kleintonno/diy-ai-gpu-server/images/r04-complete-front.png

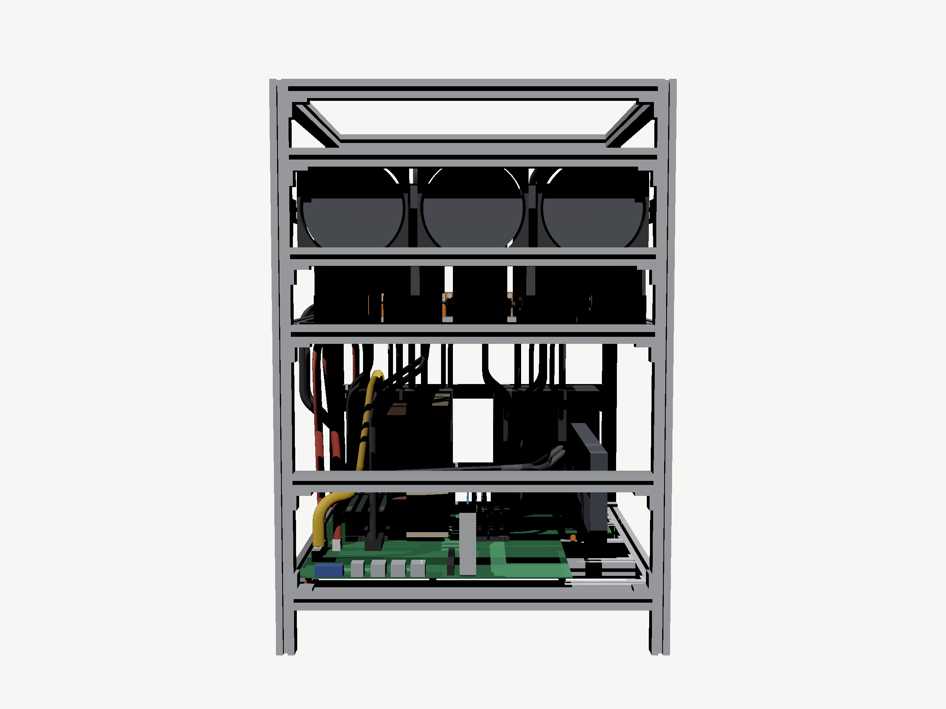
images/r04-complete-front.png
