kleintonno/diy-ai-gpu-server/images/r05-complete-top.png

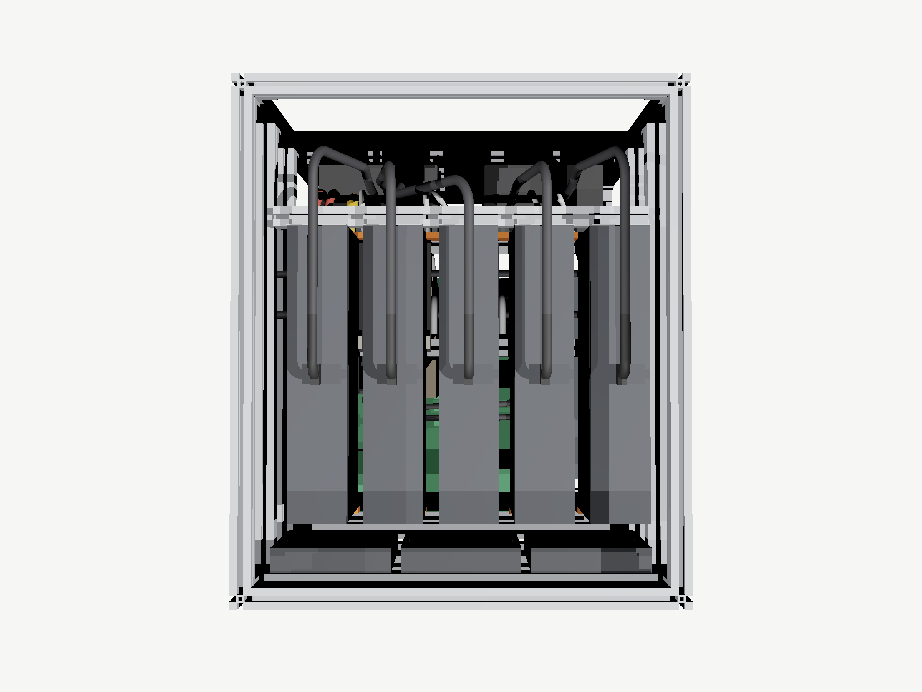
images/r05-complete-top.png
