kleintonno/diy-ai-gpu-server/images/r07-complete-left.png

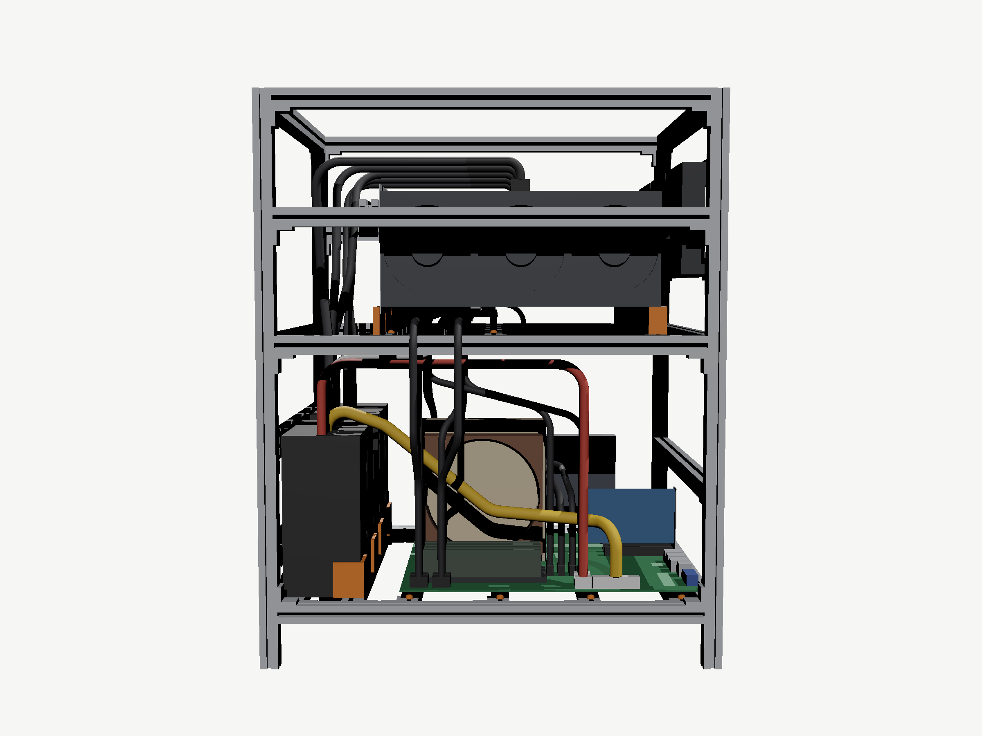
images/r07-complete-left.png
