kleintonno/diy-ai-gpu-server/images/r13-frame-iso-front-right.png

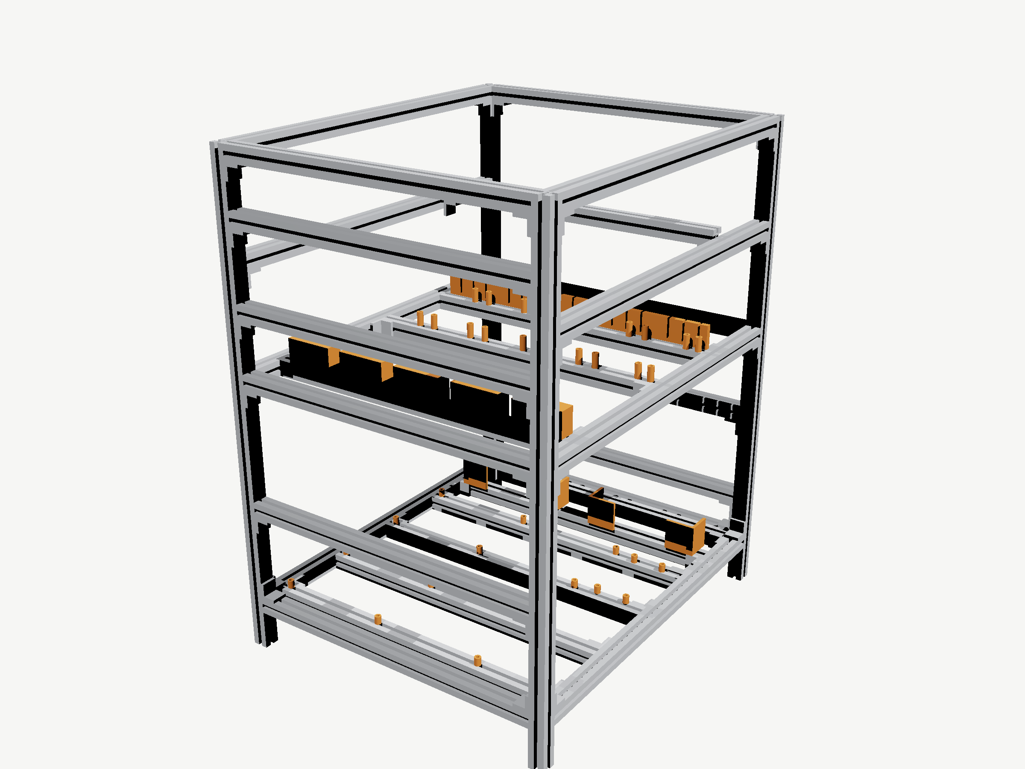
images/r13-frame-iso-front-right.png
