kleintonno/diy-ai-gpu-server/images/r15-frame-top.png

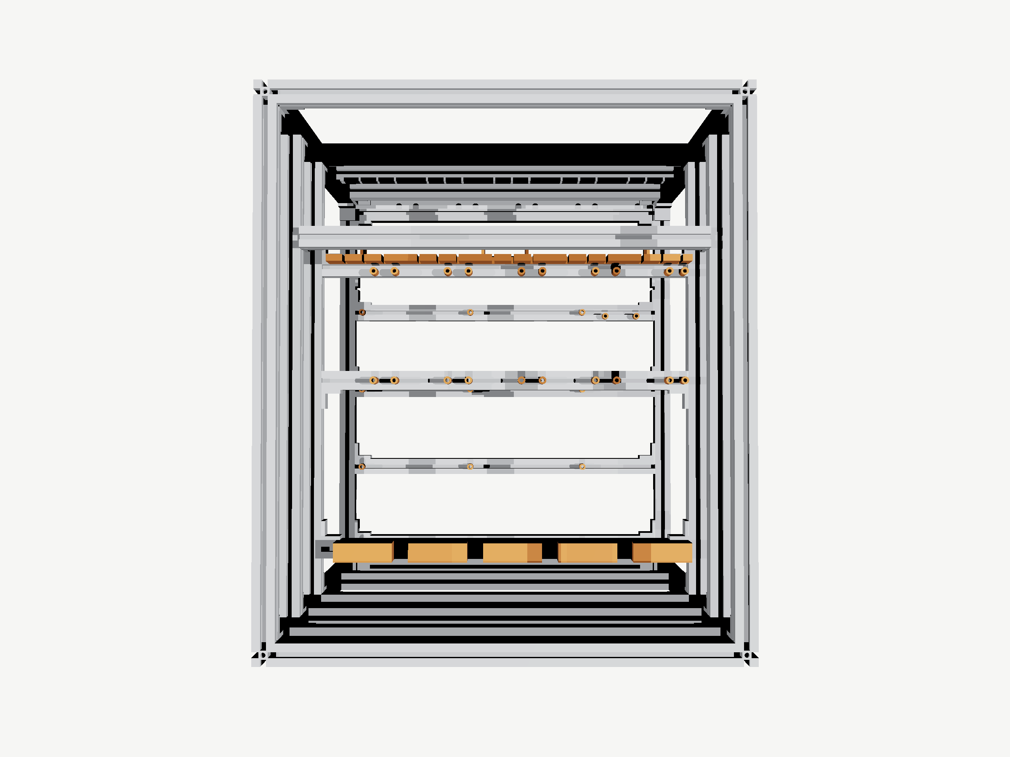
images/r15-frame-top.png
