kleintonno/diy-ai-gpu-server/images/r17-frame-left.png

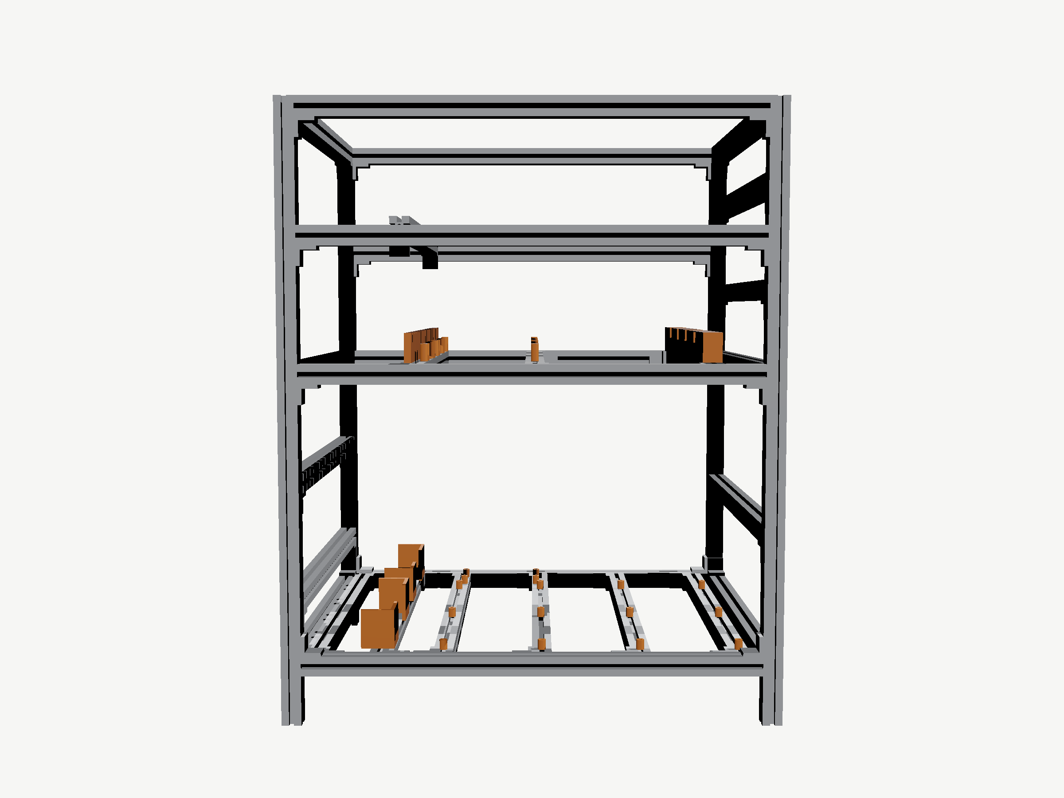
images/r17-frame-left.png
