kleintonno/diy-ai-gpu-server/bom/bom.csv

qty | part_number | description
21 | AL-2020-I5-390 | Aluminium extrusion 20x20 I-type slot 5, 390 mm
8 | AL-2020-I5-460 | Aluminium extrusion 20x20 I-type slot 5, 460 mm
4 | AL-2020-I5-621 | Aluminium extrusion 20x20 I-type slot 5, 621 mm (571 + 50 mm foot)
1 | ASRock-ROMED16QM3 | ASRock Rack ROMED16QM3 (SP3, SSI-EEB), mounted rotated 180°
6 | CPAYNE-X16-BOTTOM | C-Payne PCIe device adapter x8/x16 BOTTOM rev. 2, 2× SlimSAS 8i, 125×30 (1 optional)
16 | PRINT-STANDOFF-8x10 | Standoff Ø8×10, M3 heat-set insert on top (PETG)
24 | PRINT-STANDOFF-8x18 | Riser standoff Ø8×18, M3 heat-set insert on top (PETG)
5 | PRINT-GPU-REST | GPU front rest, 61 mm wide (PETG)
1 | PRINT-GPU6-HOLDER | 6th GPU holder: riser plate + bracket stop (PETG, optional)
1 | PRINT-COMB-1 | Bracket comb segment 1, GPU1–2 (PETG)
1 | PRINT-COMB-2 | Bracket comb segment 2, GPU3 (PETG)
1 | PRINT-COMB-3 | Bracket comb segment 3, GPU4–5 (PETG)
1 | PRINT-PSU-HOLDER-1A | PSU holder, PSU 1 outer (PETG)
1 | PRINT-PSU-HOLDER-1I | PSU holder, PSU 1 inner (PETG)
1 | PRINT-PSU-HOLDER-2A | PSU holder, PSU 2 outer (PETG)
1 | PRINT-PSU-HOLDER-2I | PSU holder, PSU 2 inner (PETG)
1 | PRINT-RACK-EAR-L | 19" rack ear left, retention only (PETG, optional)
1 | PRINT-RACK-EAR-R | 19" rack ear right, retention only (PETG, optional)
3 | FAN-120x25 | Fan 120×120×25
6 | GPU-RTX4090-3S | NVIDIA RTX 4090, 3-slot, 305 mm (1 optional as 6th GPU)
2 | IEC-C13-PLUG | IEC C13 power cord plug (placeholder)
1 | NIC-40G | 40G NIC, low profile, in PCIE8 (placeholder)
1 | Noctua-NH-U14S-TR4-SP3 | Noctua NH-U14S TR4-SP3, rotated 90°, airflow to the right
6 | PSU-CABLE-12V2X6 | 12V-2x6 cable from PSU (1 optional)
5 | PSU-CABLE-PCIE | PCIe 6+2 cable to riser
1 | PSU-CABLE-ATX24 | 24-pin ATX cable
1 | PSU-CABLE-EPS1 | EPS 4+4 CPU cable 1
1 | PSU-CABLE-EPS2 | EPS 4+4 CPU cable 2
1 | QUAD-M2 | Quad M.2 card (placeholder, alternative to 6th GPU)
8 | RDIMM-DDR4 | DDR4 RDIMM, outer slot of each channel
1 | RISER-M2 | Riser board for the quad M.2 card (placeholder)
14 | SLIMSAS-8I-500 | SlimSAS 8i (SFF-8654) cable 500 mm, round (10 for GPU1–5, 2 quad M.2, 2 optional GPU6)
2 | SST-ZU1650R | Silverstone ZEUS 1650R Titanium, upright, inlet down, fan to the rear
58 | BRACKET-2020-I5 | Corner bracket 20x20x20, I-type slot 5, with M4 screw + T-nut set
