kleintonno/diy-ai-gpu-server/drawings/dxf/assembly-top.dxf

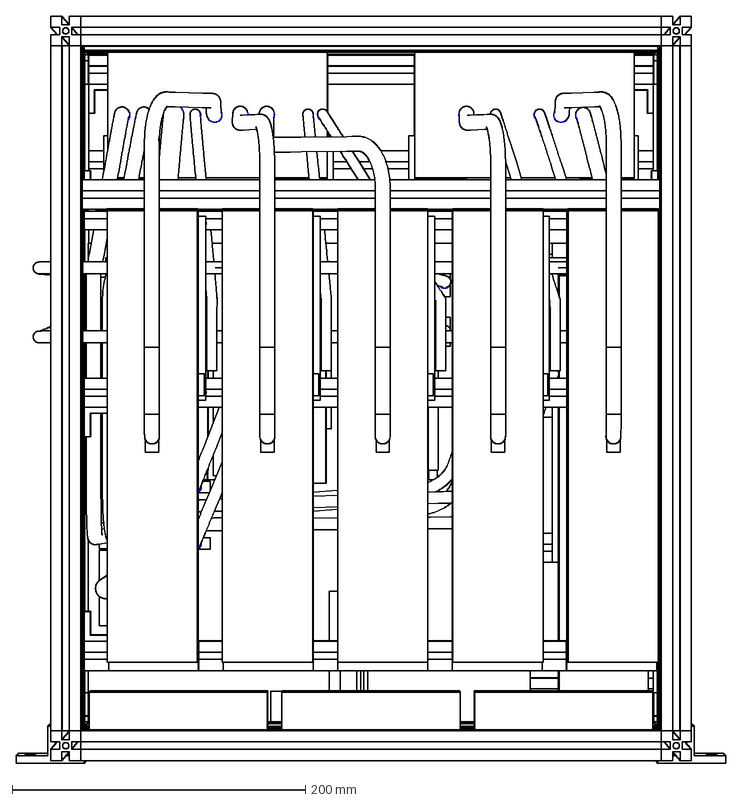
[picture p10: CAD file, 2026-10-29]
drawings/dxf/assembly-top.dxf
483.6 x 509.5 mm
