kleintonno/diy-ai-gpu-server/drawings/dxf/assembly-front.dxf

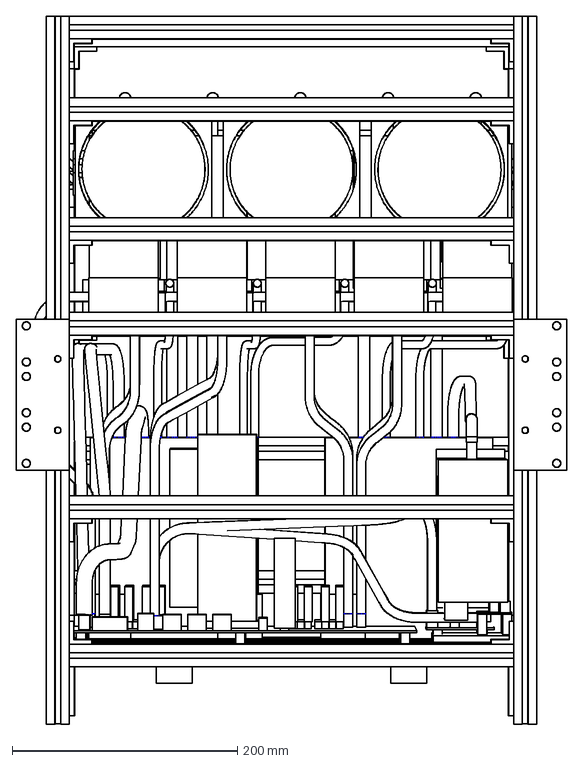
[picture p11: CAD file, 2026-10-29]
drawings/dxf/assembly-front.dxf
488.8 x 628.9 mm
