kleintonno/diy-ai-gpu-server/drawings/dxf/assembly-iso.dxf

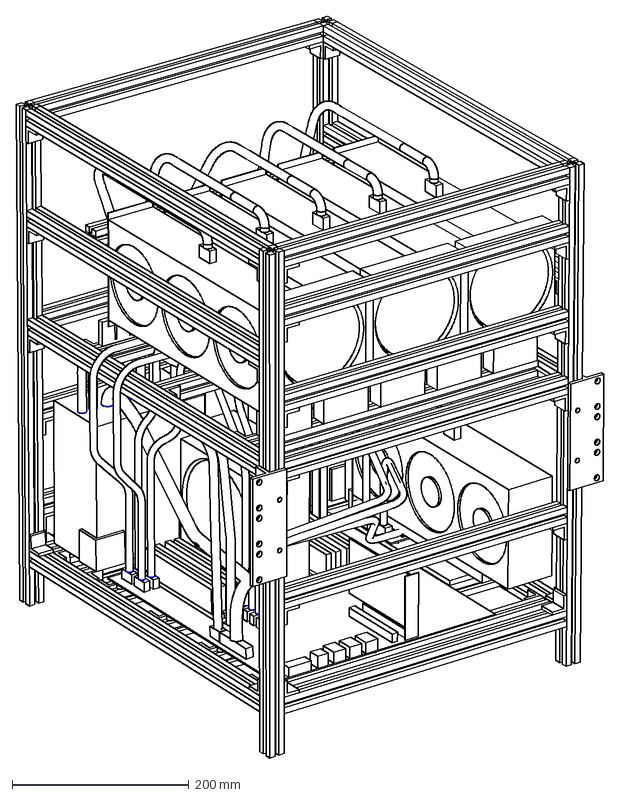
[picture p12: CAD file, 2026-10-29]
drawings/dxf/assembly-iso.dxf
665.8 x 840.2 mm
