kleintonno/diy-ai-gpu-server/drawings/dxf/assembly-left.dxf

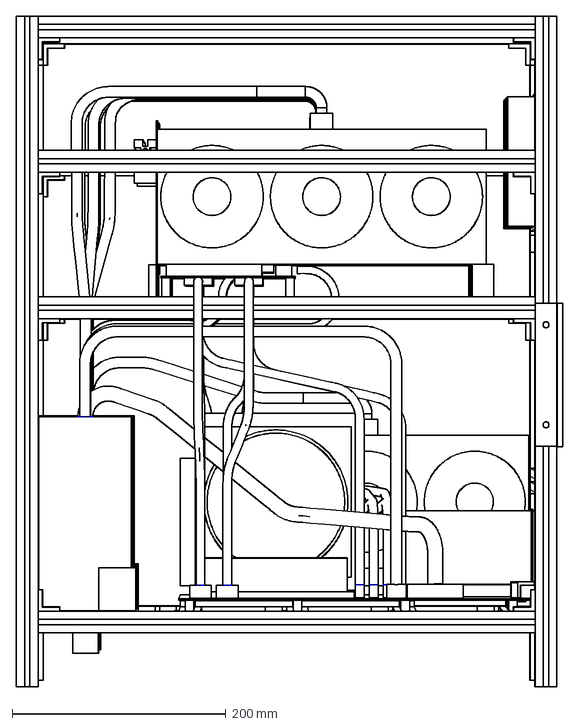
[picture p13: CAD file, 2026-10-29]
drawings/dxf/assembly-left.dxf
510.8 x 627.7 mm
