kleintonno/diy-ai-gpu-server/cad/assembly/diy-ai-gpu-server.step

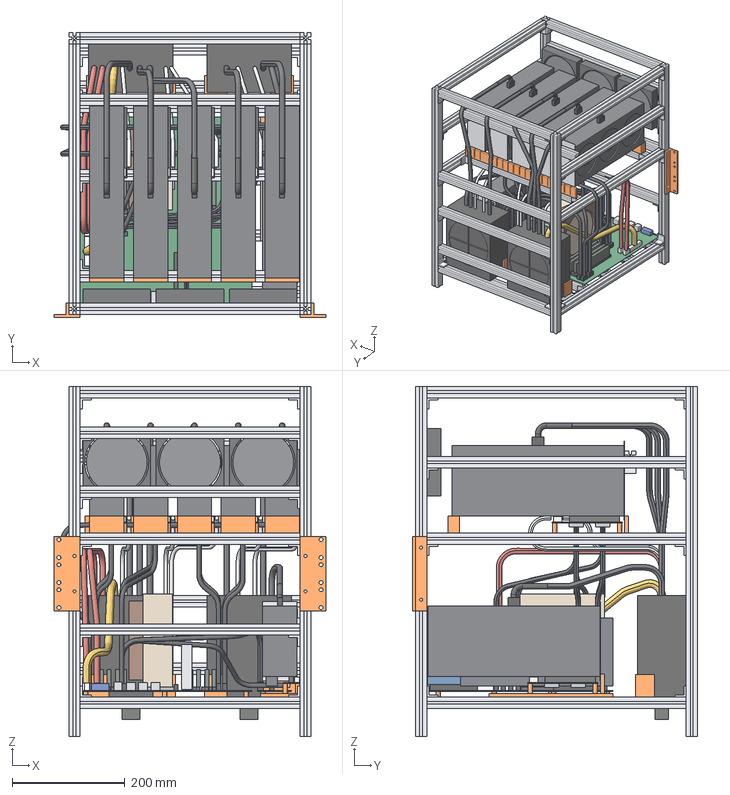
[picture p14: CAD file, 2026-10-29]
cad/assembly/diy-ai-gpu-server.step
482.6 x 505.0 x 621.0 mm
S1
S2
S4
S3
Boden_vorne
Boden_links
Boden_hinten
Boden_rechts
ZW2_vorne
ZW2_hinten
ZW2_links
ZW2_rechts
Deckel_vorne
Deckel_hinten
Deckel_links
Deckel_rechts
BoardTraeger_1
BoardTraeger_2
BoardTraeger_3
BoardTraeger_4
RiserTraeger_1
RiserTraeger_2
GPU_Stuetze_vorne
GPU_Seite_links
GPU_Seite_rechts
Luefter_GPU_vorne_unten
Luefter_GPU_vorne_oben
Luefter_Board_hinten_unten
Luefter_Board_hinten_oben
NIC_Schiene
W_Boden_vorne_L
W_Boden_vorne_R
W_Boden_hinten_L
W_Boden_hinten_R
W_Boden_links_V
W_Boden_links_H
W_Boden_rechts_V
W_Boden_rechts_H
W_ZW2_vorne_L
W_ZW2_vorne_R
W_ZW2_hinten_L
W_ZW2_hinten_R
W_ZW2_links_V
W_ZW2_links_H
W_ZW2_rechts_V
W_ZW2_rechts_H
W_Deckel_vorne_L
W_Deckel_vorne_R
W_Deckel_hinten_L
W_Deckel_hinten_R
W_Deckel_links_V
W_Deckel_links_H
W_Deckel_rechts_V
W_Deckel_rechts_H
W_BoardTraeger_1_L
W_BoardTraeger_1_R
W_BoardTraeger_2_L
W_BoardTraeger_2_R
W_BoardTraeger_3_L
W_BoardTraeger_3_R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
