kleintonno/diy-ai-gpu-server/cad/parts/profile-2020-i5-460mm.step

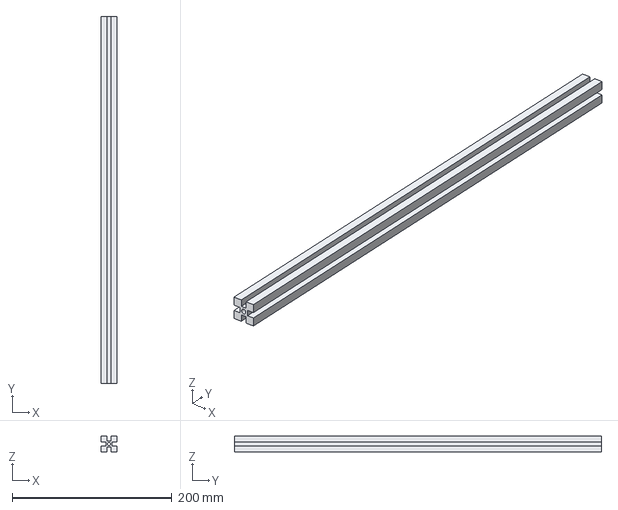
[picture p15: CAD file, 2026-10-29]
cad/parts/profile-2020-i5-460mm.step
20.0 x 460.0 x 20.0 mm
