kleintonno/diy-ai-gpu-server/drawings/dxf/frame-top.dxf

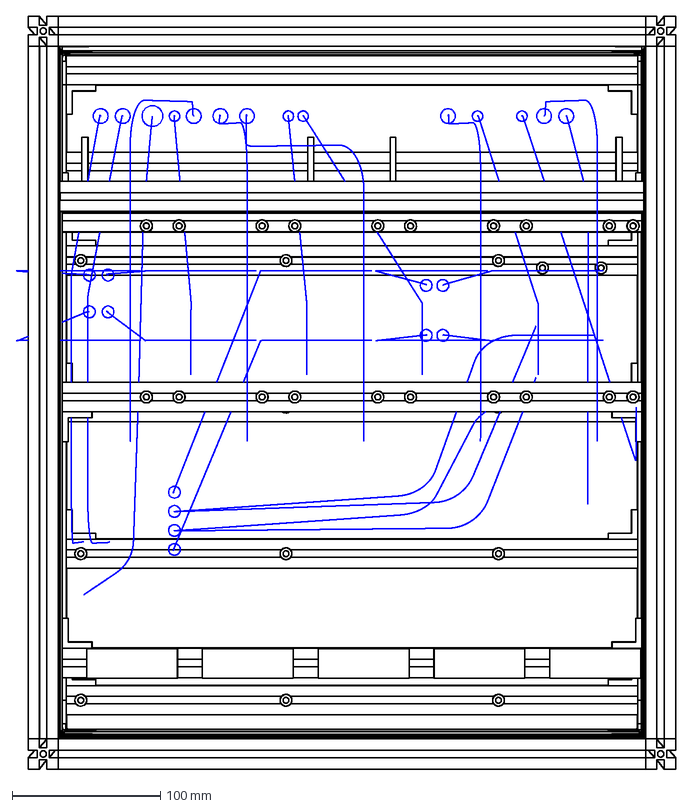
[picture p16: CAD file, 2026-10-29]
drawings/dxf/frame-top.dxf
444.8 x 507.8 mm
