kleintonno/diy-ai-gpu-server/print/step/psu-holder-1-outer.step

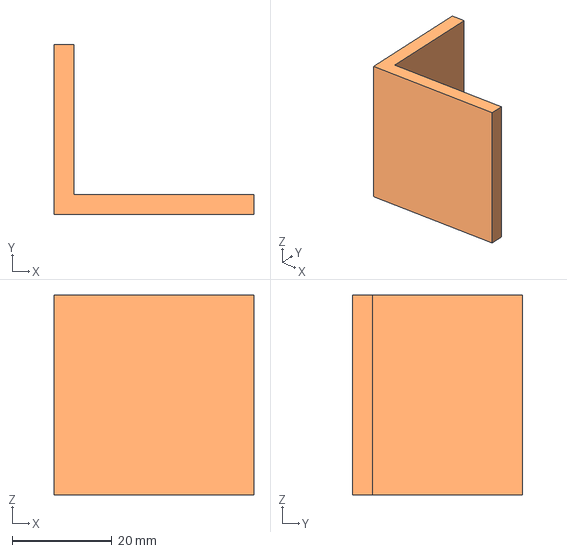
[picture p17: CAD file, 2026-10-29]
print/step/psu-holder-1-outer.step
40.0 x 34.0 x 40.0 mm
