kleintonno/diy-ai-gpu-server/sheet-metal/fan-panel-120_AlMg3_3mm.step

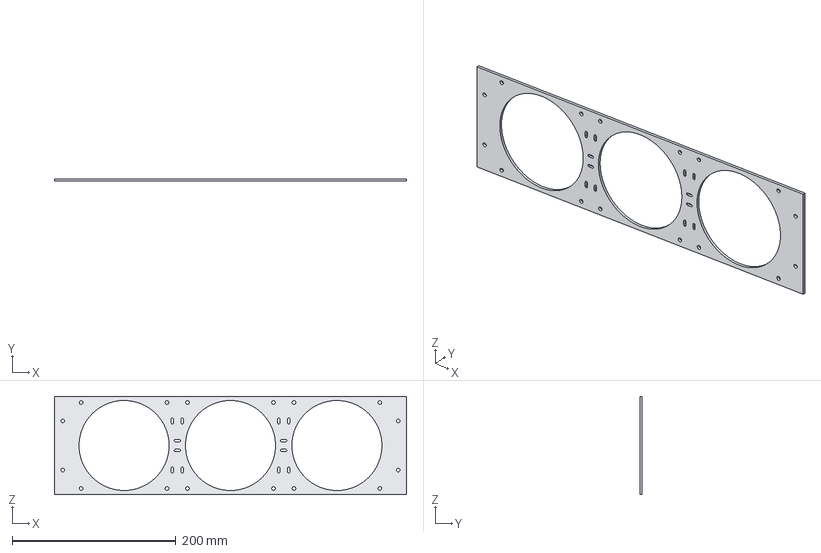
[picture p18: CAD file, 2026-10-29]
sheet-metal/fan-panel-120_AlMg3_3mm.step
430.0 x 3.00 x 120.0 mm
