kleintonno/diy-ai-gpu-server/cad/assembly/frame-and-printed-parts.step

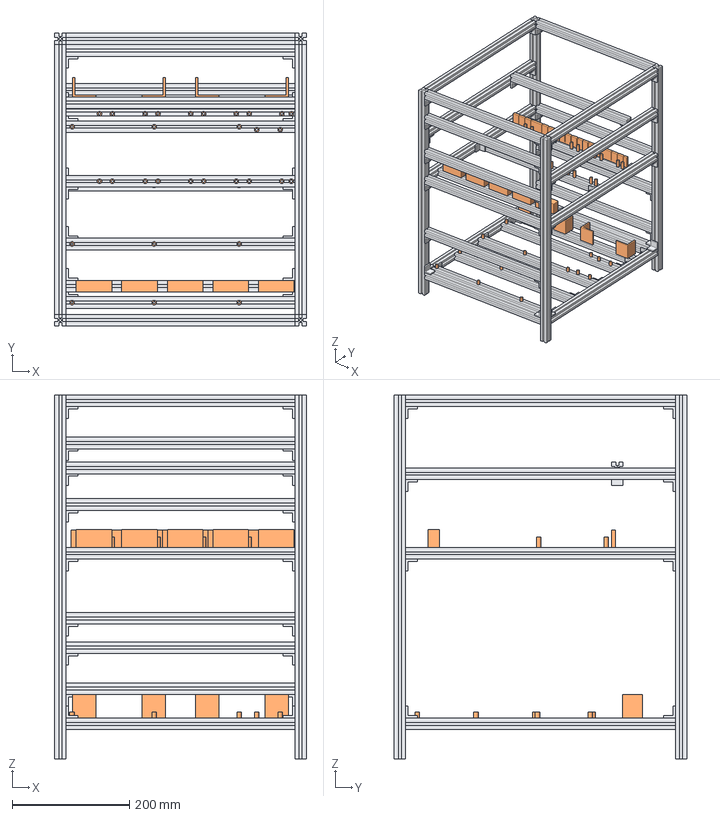
[picture p19: CAD file, 2026-10-29]
cad/assembly/frame-and-printed-parts.step
430.0 x 500.0 x 621.0 mm
