kleintonno/diy-ai-gpu-server/cad/parts/profile-2020-i5-621mm.step

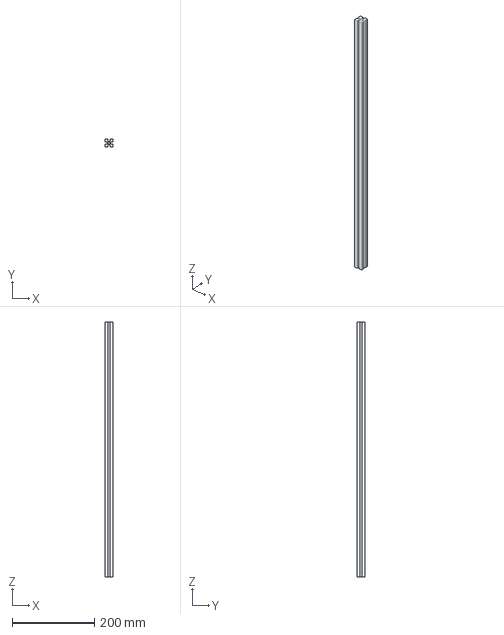
[picture p20: CAD file, 2026-10-29]
cad/parts/profile-2020-i5-621mm.step
20.0 x 20.0 x 621.0 mm
