kleintonno/diy-ai-gpu-server/print/step/bracket-comb-3.step

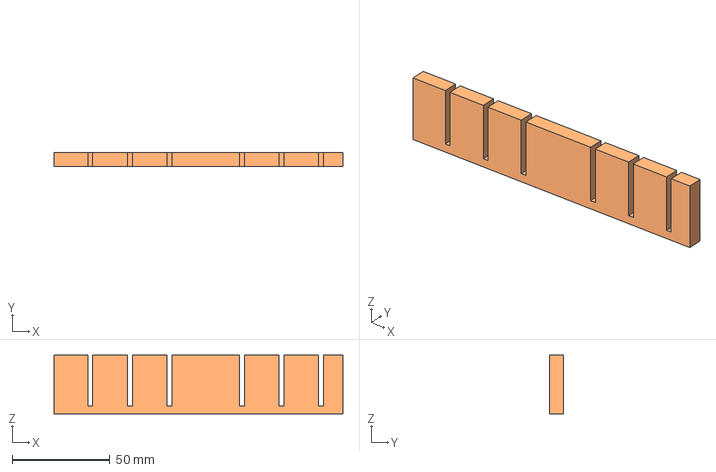
[picture p21: CAD file, 2026-10-29]
print/step/bracket-comb-3.step
148.2 x 7.00 x 30.0 mm
