kleintonno/diy-ai-gpu-server/sheet-metal/base-plate_AlMg3_3mm.step

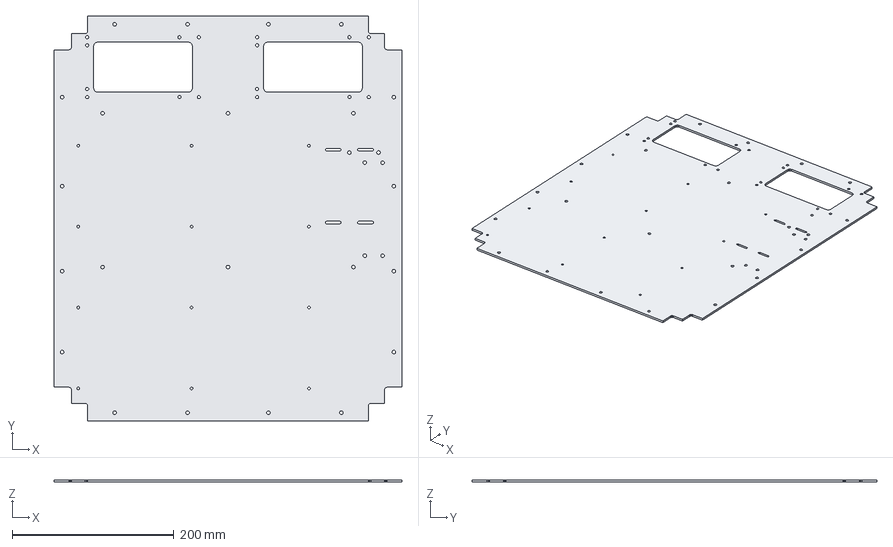
[picture p22: CAD file, 2026-10-29]
sheet-metal/base-plate_AlMg3_3mm.step
430.0 x 500.0 x 3.00 mm
