kleintonno/diy-ai-gpu-server/cad/parts/corner-bracket-20x20.step

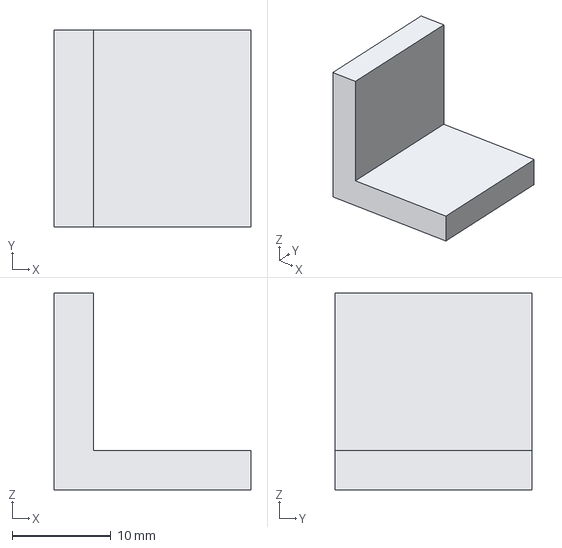
[picture p23: CAD file, 2026-10-29]
cad/parts/corner-bracket-20x20.step
20.0 x 20.0 x 20.0 mm
