kleintonno/diy-ai-gpu-server/print/step/rack-ear-left-optional.step

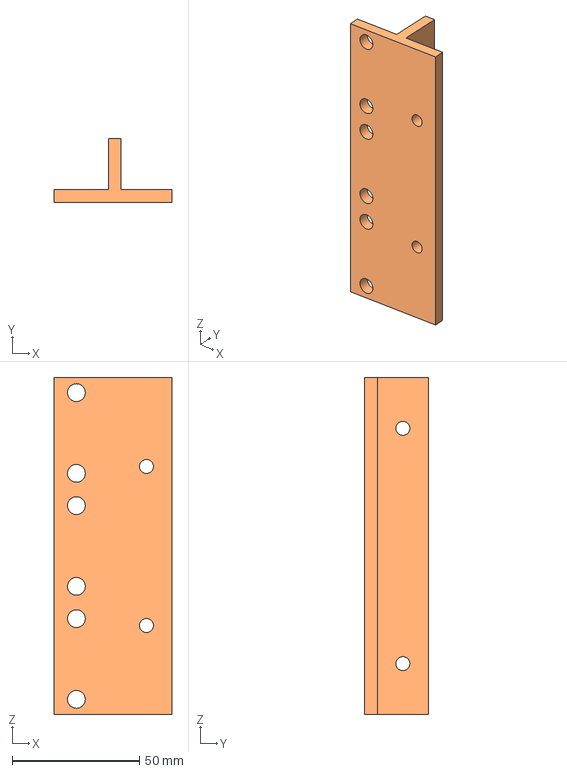
[picture p24: CAD file, 2026-10-29]
print/step/rack-ear-left-optional.step
46.3 x 25.0 x 132.6 mm
