kleintonno/diy-ai-gpu-server/cad/parts/profile-2020-i5-390mm.step

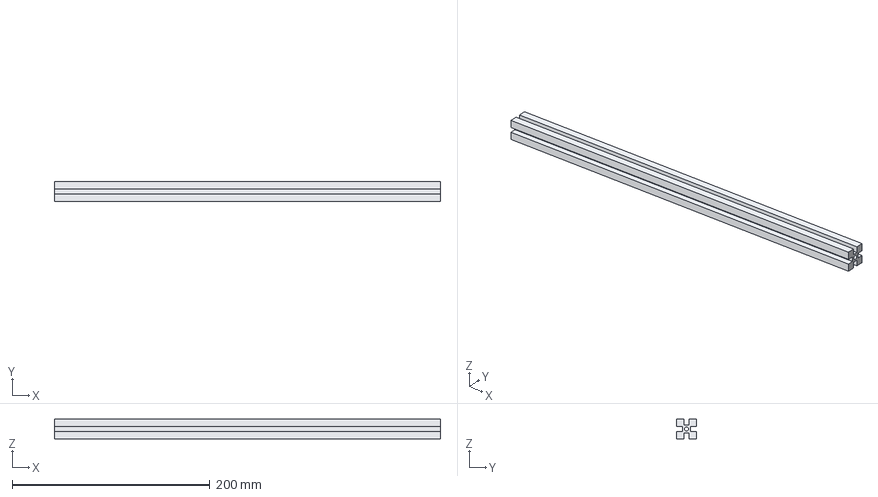
[picture p25: CAD file, 2026-10-29]
cad/parts/profile-2020-i5-390mm.step
390.0 x 20.0 x 20.0 mm
