kleintonno/diy-ai-gpu-server/drawings/dxf/frame-front.dxf

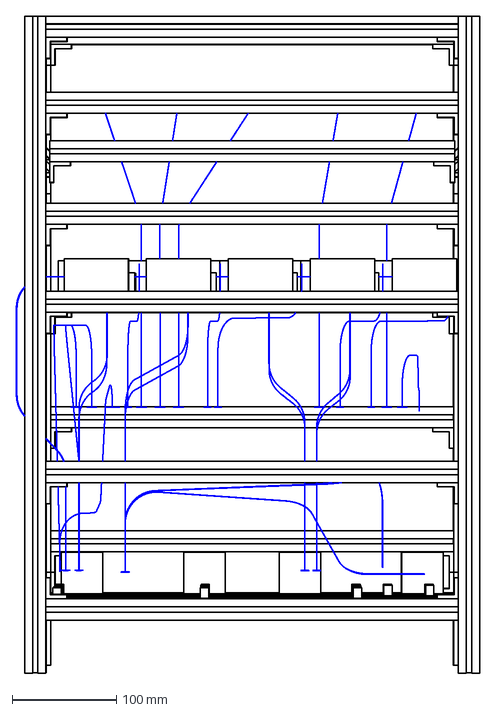
[picture p26: CAD file, 2026-10-29]
drawings/dxf/frame-front.dxf
443.3 x 628.9 mm
