kleintonno/diy-ai-gpu-server/print/step/standoff-8x10.step

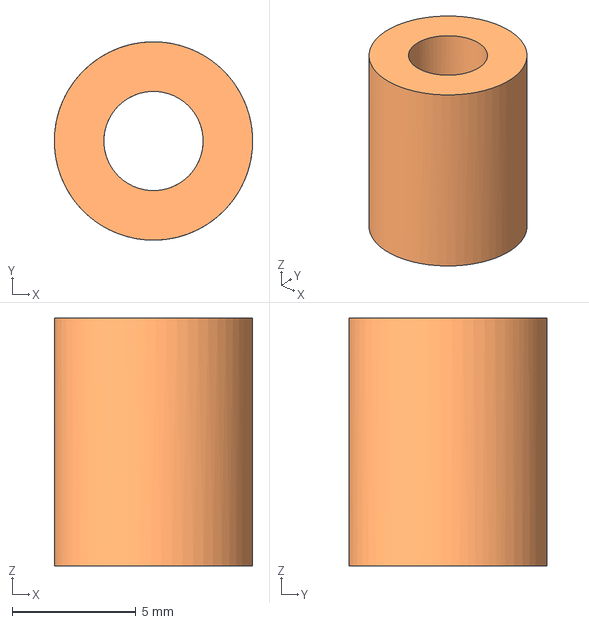
[picture p27: CAD file, 2026-10-29]
print/step/standoff-8x10.step
8.00 x 8.00 x 10.0 mm
