kleintonno/diy-ai-gpu-server/drawings/dxf/frame-iso.dxf

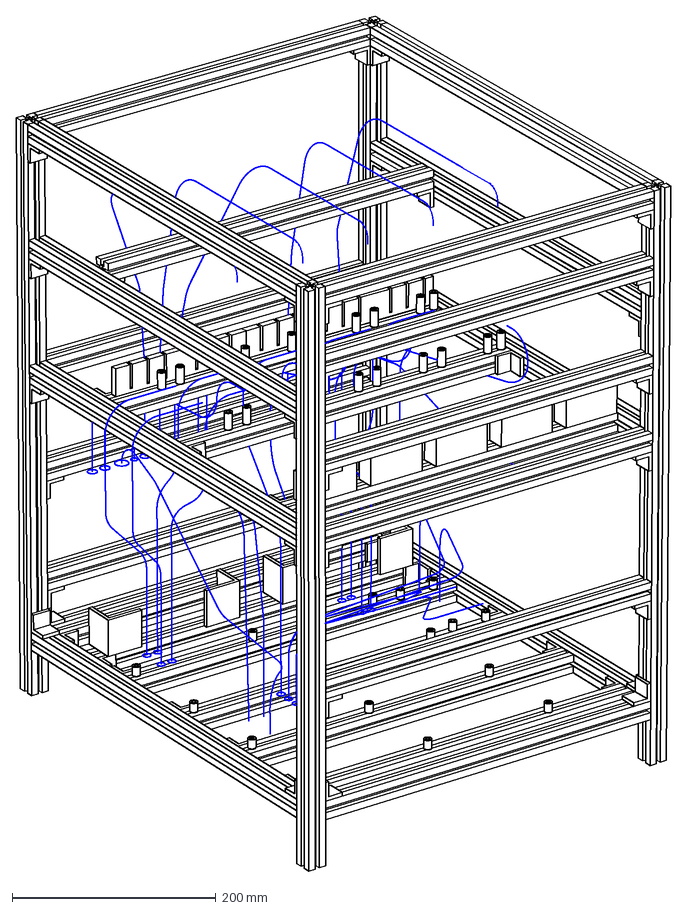
[picture p28: CAD file, 2026-10-29]
drawings/dxf/frame-iso.dxf
643.2 x 840.2 mm
