kleintonno/diy-ai-gpu-server/print/step/gpu6-holder-optional.step

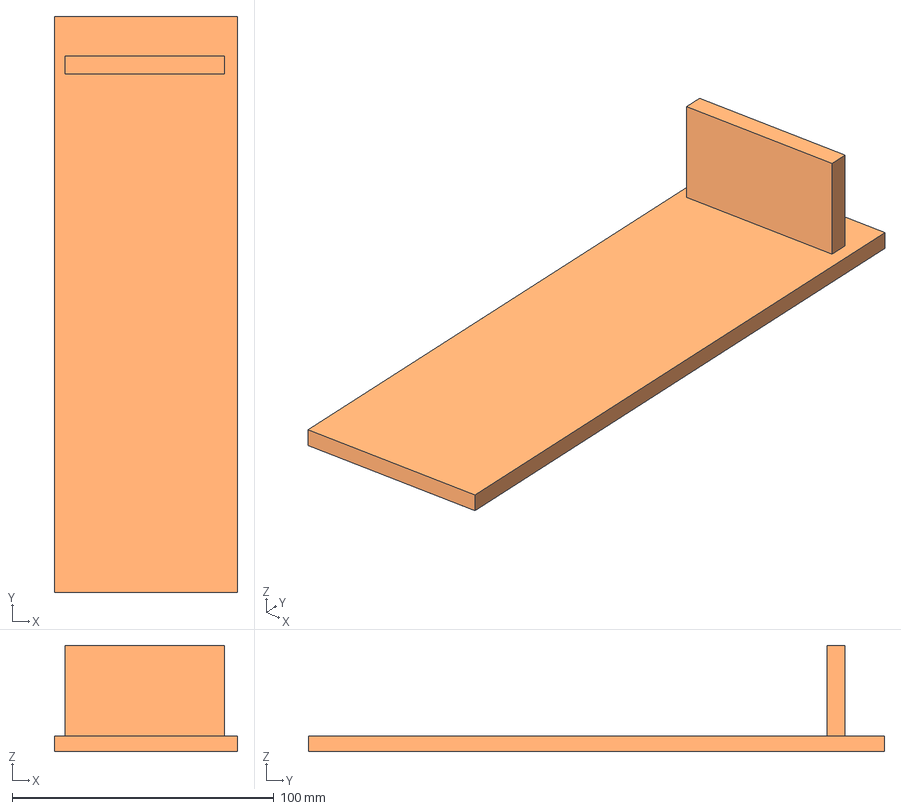
[picture p29: CAD file, 2026-10-29]
print/step/gpu6-holder-optional.step
70.0 x 220.0 x 40.6 mm
