kleintonno/diy-ai-gpu-server/drawings/dxf/frame-left.dxf

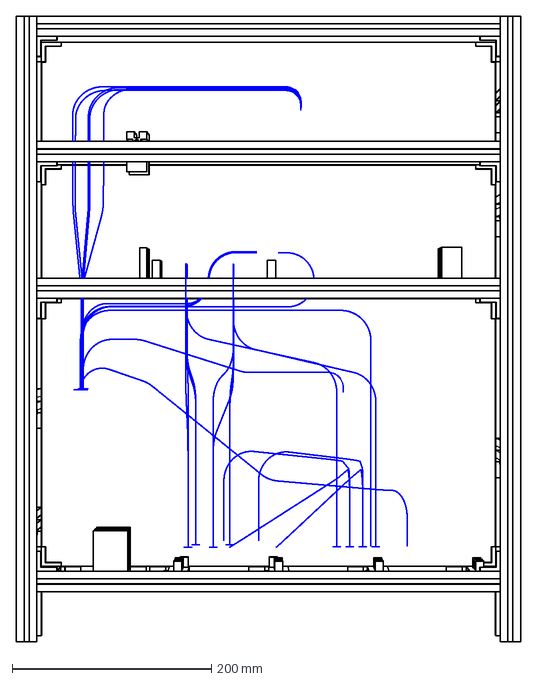
[picture p30: CAD file, 2026-10-29]
drawings/dxf/frame-left.dxf
505.4 x 627.7 mm
