kleintonno/diy-ai-gpu-server/print/step/gpu-front-rest.step

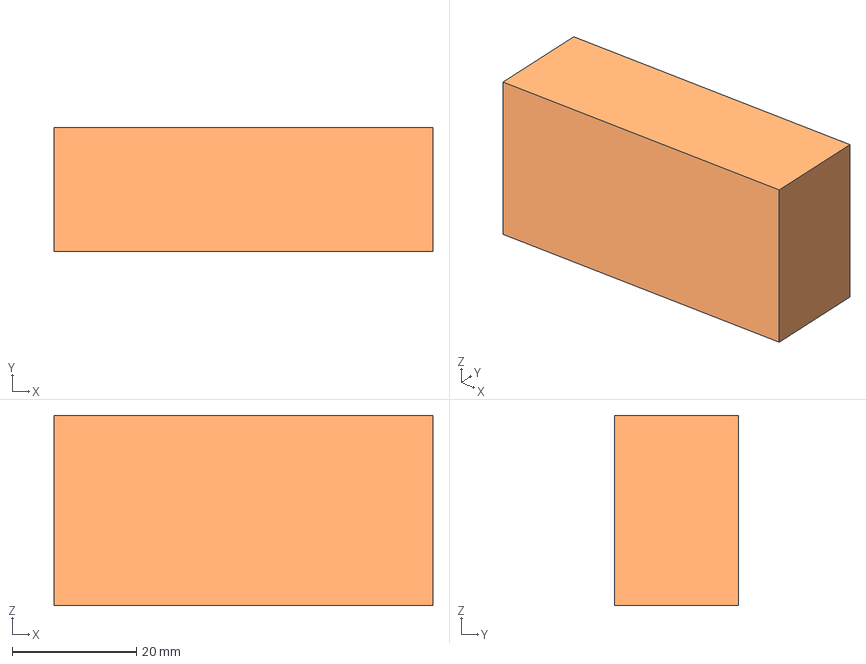
[picture p31: CAD file, 2026-10-29]
print/step/gpu-front-rest.step
61.0 x 20.0 x 30.6 mm
