kleintonno/diy-ai-gpu-server/print/step/bracket-comb-2.step

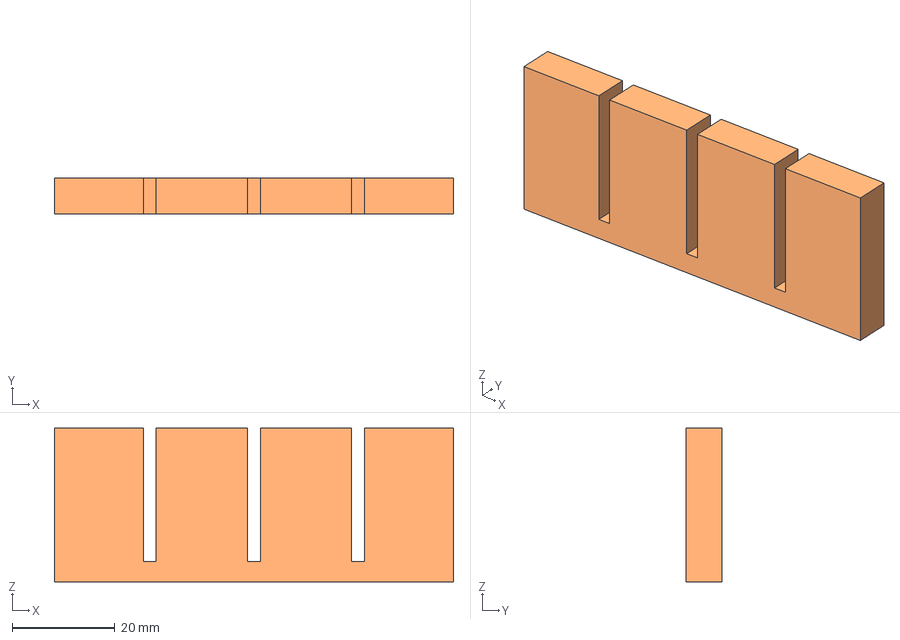
[picture p32: CAD file, 2026-10-29]
print/step/bracket-comb-2.step
77.8 x 7.00 x 30.0 mm
