kleintonno/diy-ai-gpu-server/print/step/bracket-comb-1.step

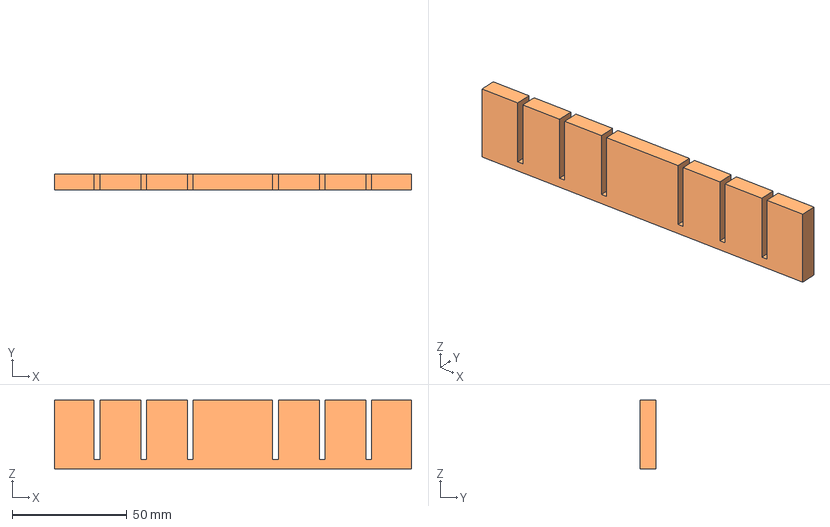
[picture p33: CAD file, 2026-10-29]
print/step/bracket-comb-1.step
155.6 x 7.00 x 30.0 mm
