kleintonno/diy-ai-gpu-server/print/step/standoff-8x18-riser.step

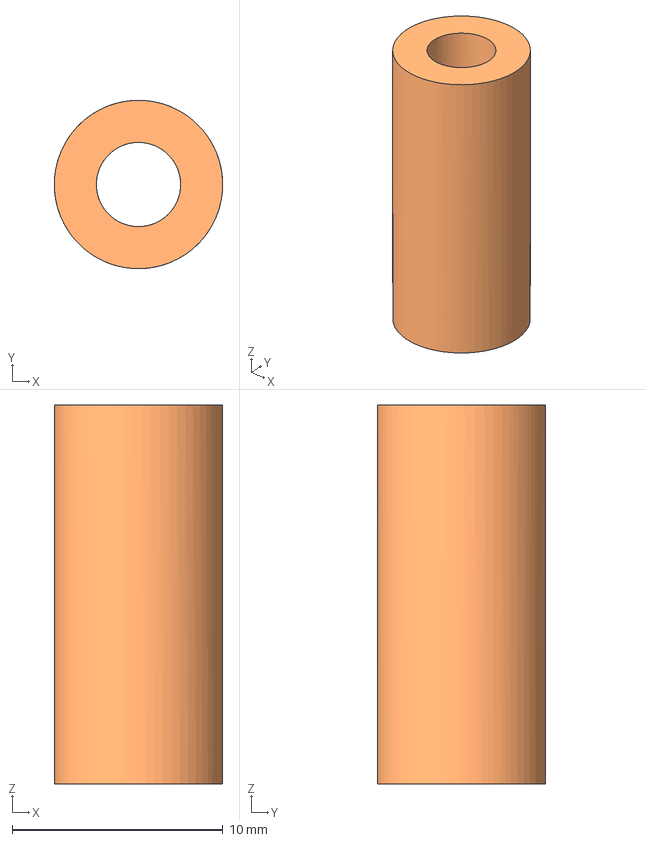
[picture p34: CAD file, 2026-10-29]
print/step/standoff-8x18-riser.step
8.00 x 7.99 x 18.0 mm
