kleintonno/diy-ai-gpu-server/(list of files, cad)

Other CAD files:
print/step/rack-ear-right-optional.step
print/step/psu-holder-2-inner.step
print/step/psu-holder-2-outer.step
print/step/psu-holder-1-inner.step
cad/assembly/diy-ai-gpu-server.3mf
print/3mf/bracket-comb-1.3mf
print/3mf/bracket-comb-2.3mf
print/3mf/bracket-comb-3.3mf
print/3mf/gpu-front-rest.3mf
print/3mf/gpu6-holder-optional.3mf
print/3mf/psu-holder-1-inner.3mf
print/3mf/psu-holder-1-outer.3mf
print/3mf/psu-holder-2-inner.3mf
print/3mf/psu-holder-2-outer.3mf
print/3mf/rack-ear-left-optional.3mf
print/3mf/rack-ear-right-optional.3mf
print/3mf/standoff-8x10.3mf
print/3mf/standoff-8x18-riser.3mf
print/stl/bracket-comb-1.stl
print/stl/bracket-comb-2.stl
print/stl/bracket-comb-3.stl
print/stl/gpu-front-rest.stl
print/stl/gpu6-holder-optional.stl
print/stl/psu-holder-1-inner.stl
print/stl/psu-holder-1-outer.stl
print/stl/psu-holder-2-inner.stl
print/stl/psu-holder-2-outer.stl
print/stl/rack-ear-left-optional.stl
print/stl/rack-ear-right-optional.stl
print/stl/standoff-8x10.stl
print/stl/standoff-8x18-riser.stl
sheet-metal/base-plate_AlMg3_3mm.dxf
sheet-metal/fan-panel-120_AlMg3_3mm.dxf
