kleintonno/diy-ai-gpu-server/(commit log)

2026-10-29 Initial release: DIY AI GPU Server (14U, 5-6x RTX 4090)
    Open 19" frame from 20x20 I-type slot 5 extrusion for multi consumer GPU
    AI/LLM servers: CAD (STEP AP242, 3MF, OBJ, native SolidCraft source),
    printed parts (STL/3MF/STEP), 2D drawings (DXF/SVG), BOM CSVs,
    illustrated assembly guide (PDF + Typst) and renderings.
    Licensed under CERN-OHL-P v2.
    Claude-Session: https://claude.ai/code/session_01Akeuj7XJ3YJ9GnWiSPS8YP
    [assembly-front.dxf, assembly-iso.dxf, assembly-left.dxf, assembly-top.dxf, bom.csv, bracket-comb-1.3mf, bracket-comb-1.step, bracket-comb-1.stl]
2026-10-29 README: mark project as early stage, add roadmap
    The design has not been built yet; first assembly and testing happen over
    the coming weeks. Planned next: fan position optimisation, photos of the
    finished rig, temperature/noise/power measurements and a sheet-metal
    variant.
    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
2026-10-29 Add untested sheet-metal variant (base plate, stackable fan panel)
    Flat AlMg3 3 mm plates as an alternative to several inner extrusions:
    base plate for mainboard + PSUs (with PSU exhaust/plug cut-outs) and a
    120 mm fan panel that stacks on the corner posts, with paired cable-tie
    slots. DXF R12 for laser/waterjet/CNC, SVG previews, hole tables and the
    base-plate STEP. Not cut or fitted yet.
    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
    [base-plate_AlMg3_3mm.dxf, base-plate_AlMg3_3mm.step, base-plate_AlMg3_3mm_holes.csv, fan-panel-120_AlMg3_3mm.dxf, fan-panel-120_AlMg3_3mm_holes.csv]
2026-10-29 sheet-metal: add fan-panel STEP, note top-front bracket position
    Fan panel exported with the paired cable-tie slots. In the sheet-metal
    variant the two top-front corner brackets sit horizontally in the
    top-frame corners so the upper fan row has its full 240 mm.
    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
    [fan-panel-120_AlMg3_3mm.step]
2026-10-29 sheet-metal: English product name in fan-panel STEP
    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
    [fan-panel-120_AlMg3_3mm.step]
